SpindlySpider/spindlyVR/parts/PCB_body/body_ver0.FCStd

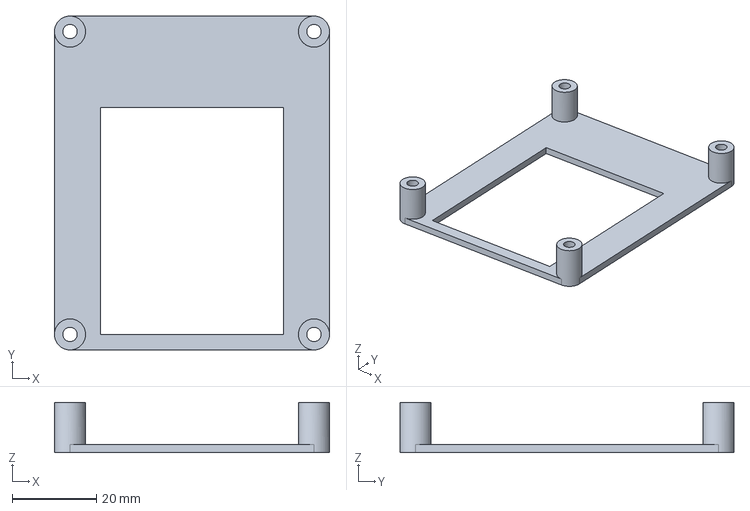
[picture p1: CAD file, 2026-05-15]
parts/PCB_body/body_ver0.FCStd
65.4 x 79.4 x 12.0 mm
