SpindlySpider/spindlyVR/parts/spools/adjustable_spool.FCStd

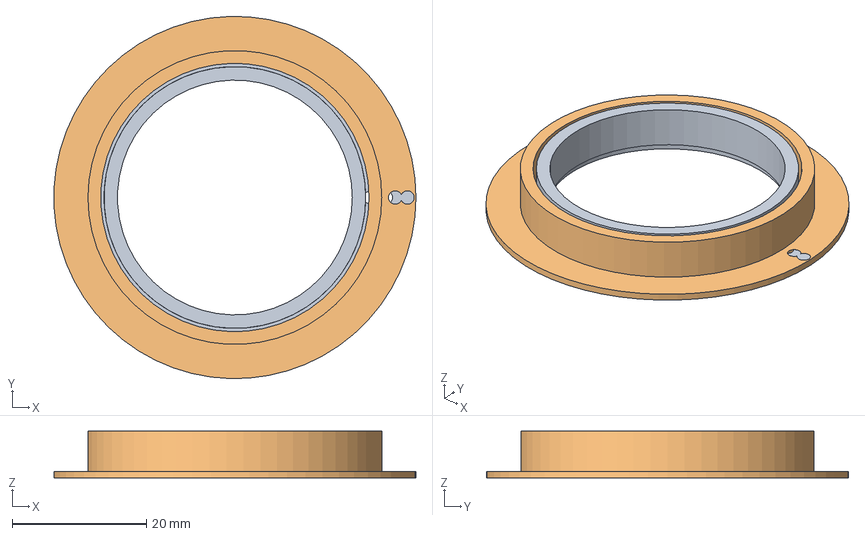
[picture p2: CAD file, 2026-05-15]
parts/spools/adjustable_spool.FCStd
54.0 x 54.0 x 7.00 mm
spool_top
spool_bottom
