SpindlySpider/spindlyVR/parts/tri-axis-magnet/ver-6-coil_001.step

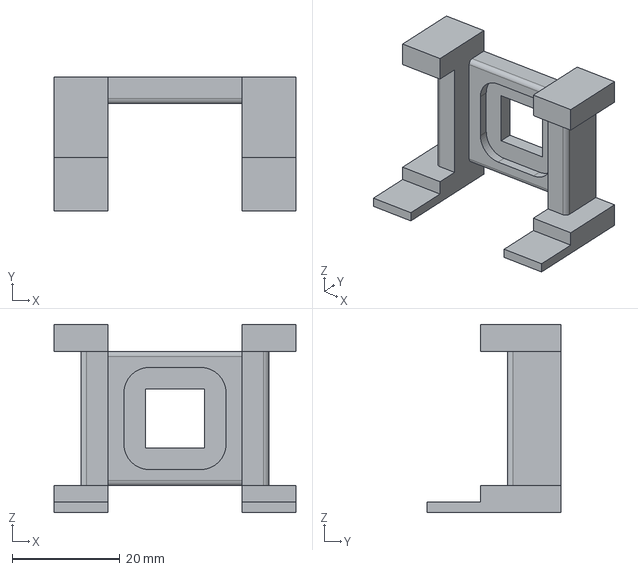
[picture p3: CAD file, 2026-05-15]
parts/tri-axis-magnet/ver-6-coil_001.step
45.0 x 25.0 x 35.0 mm
