SpindlySpider/spindlyVR/parts/tri-axis-magnet/ver-7.FCStd

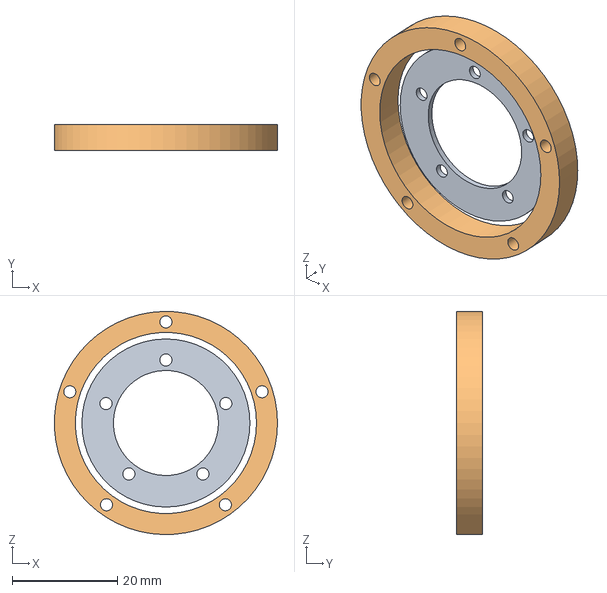
[picture p4: CAD file, 2026-05-15]
parts/tri-axis-magnet/ver-7.FCStd
42.5 x 5.00 x 42.5 mm
coil_1_flange
coil_2_hub
