SpindlySpider/spindlyVR/parts/tri-axis-magnet/ver-6-key001.step

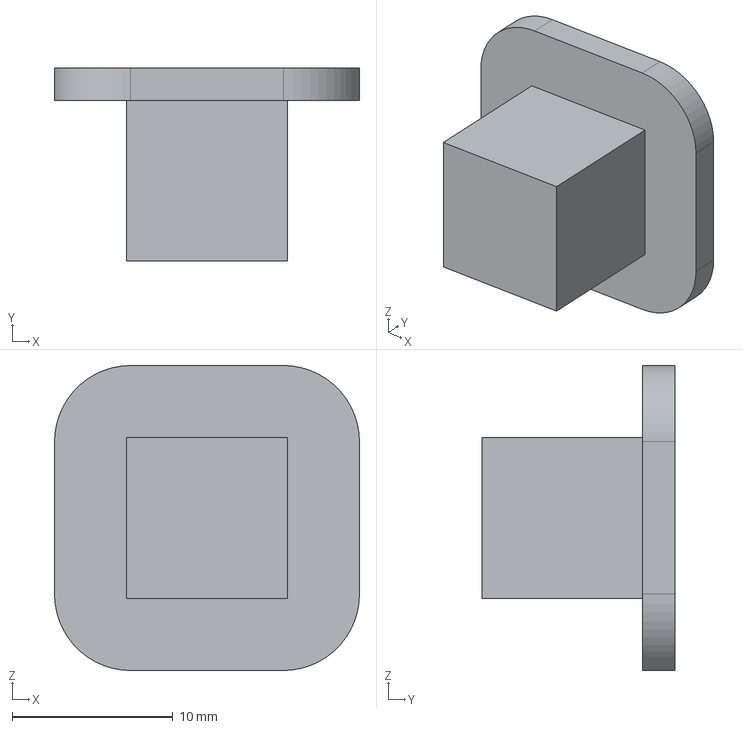
[picture p5: CAD file, 2026-05-15]
parts/tri-axis-magnet/ver-6-key001.step
19.0 x 12.0 x 19.0 mm
