SpindlySpider/spindlyVR/parts/tri-axis-magnet/ver-6-coil_003.step

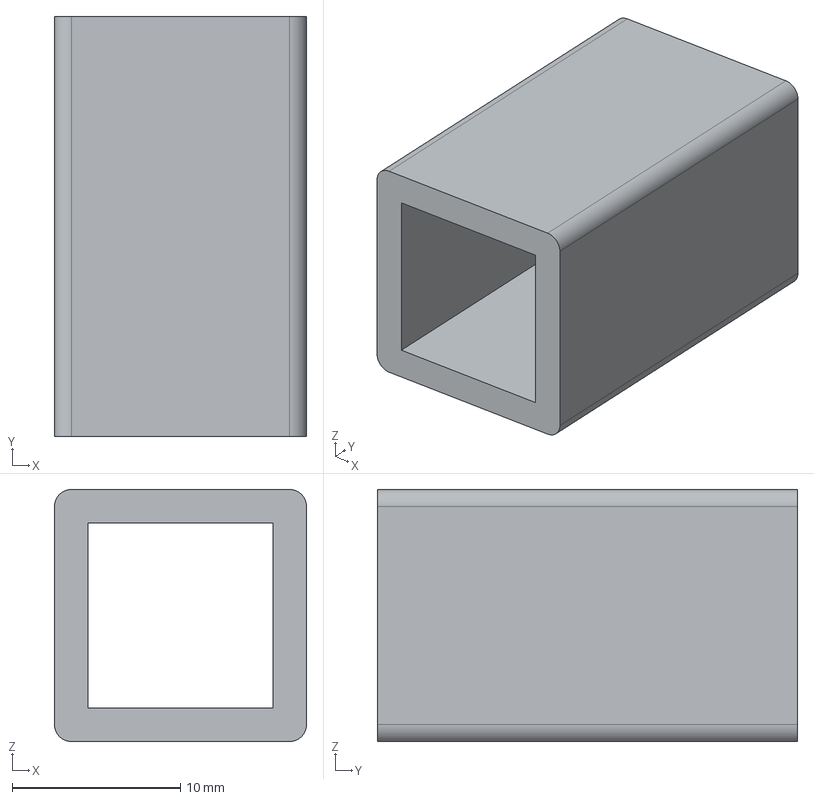
[picture p6: CAD file, 2026-05-15]
parts/tri-axis-magnet/ver-6-coil_003.step
15.0 x 25.0 x 15.0 mm
