SpindlySpider/spindlyVR/parts/tri-axis-magnet/ver-4-stepper-motor.FCStd

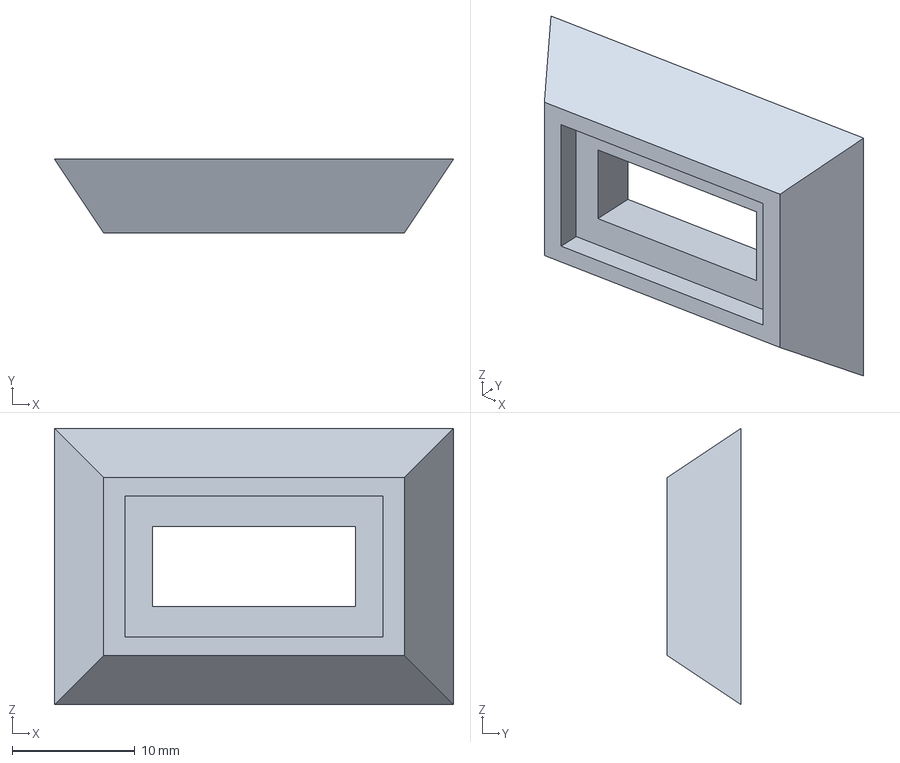
[picture p7: CAD file, 2025-12-07]
parts/tri-axis-magnet/ver-4-stepper-motor.FCStd
32.5 x 6.00 x 22.5 mm
