SpindlySpider/spindlyVR/parts/tri-axis-magnet/ver-3-stepper-mount.FCStd .FCStd

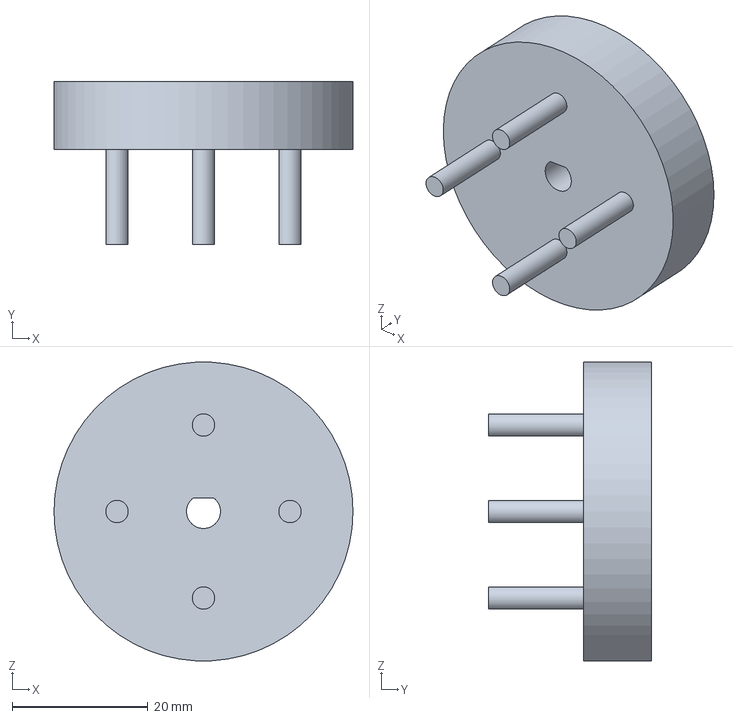
[picture p8: CAD file, 2025-12-04]
parts/tri-axis-magnet/ver-3-stepper-mount.FCStd .FCStd
44.0 x 24.0 x 43.9 mm
