SpindlySpider/spindlyVR/parts/tri-axis-magnet/ver-1-stepper-mount.FCStd

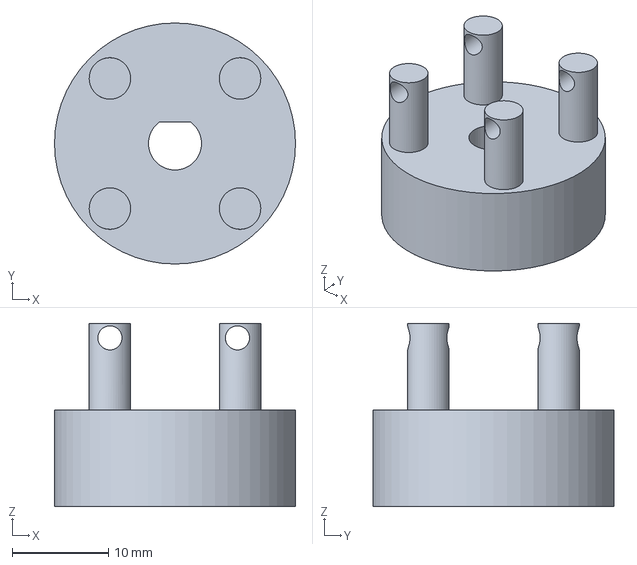
[picture p9: CAD file, 2025-12-03]
parts/tri-axis-magnet/ver-1-stepper-mount.FCStd
25.0 x 25.0 x 19.0 mm
