SpindlySpider/spindlyVR/parts/tri-axis-magnet/ver-6.FCStd

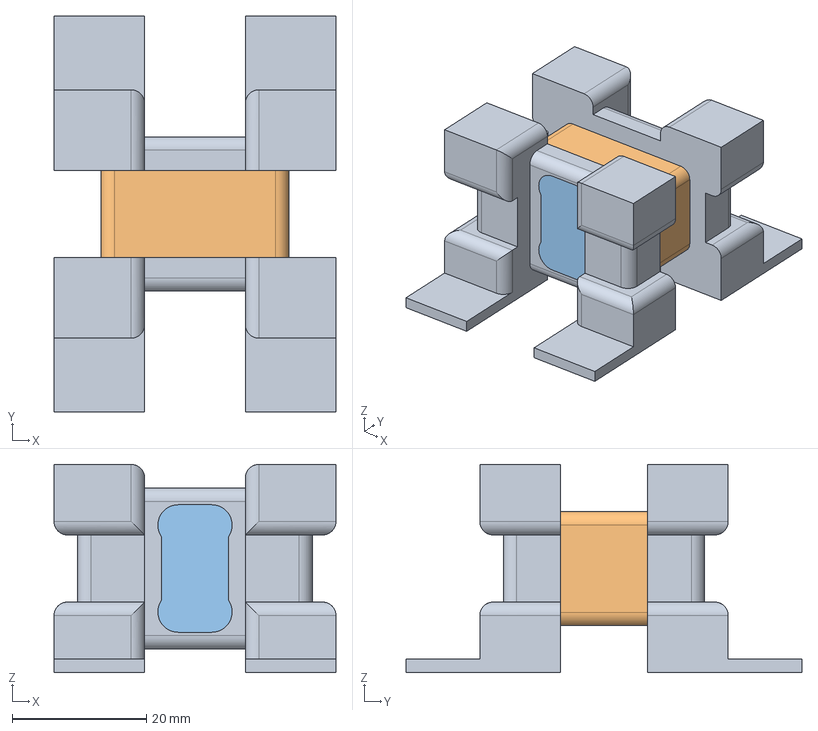
[picture p10: CAD file, 2026-05-15, an earlier design]
parts/tri-axis-magnet/ver-6.FCStd
42.0 x 59.0 x 31.0 mm
coil_1 x 2
coil_2
key x 2
