SpindlySpider/spindlyVR/parts/tri-axis-magnet/ver-5.FCStd

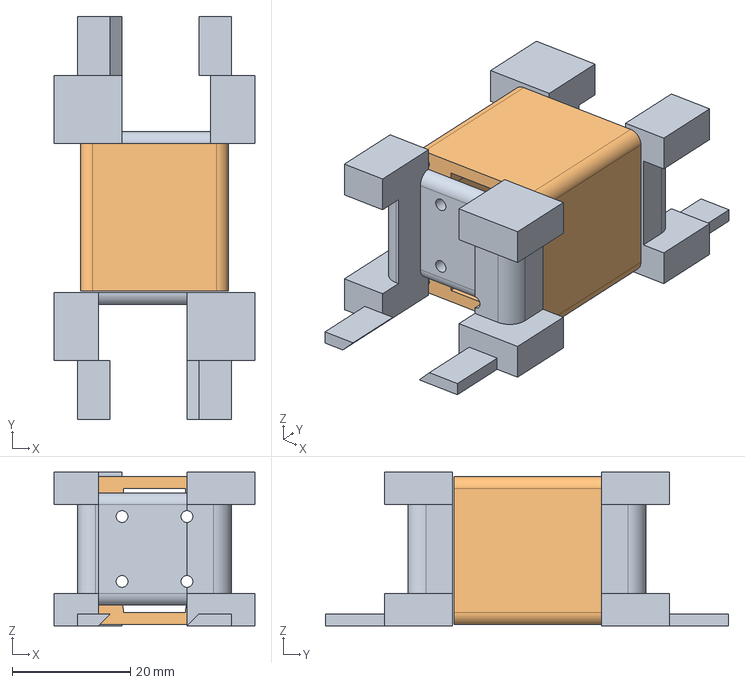
[picture p11: CAD file, 2026-05-15, an earlier design]
parts/tri-axis-magnet/ver-5.FCStd
34.0 x 68.2 x 26.0 mm
coil_1 x 2
coil_2
