SpindlySpider/spindlyVR/parts/tri-axis-magnet/ver-3.FCStd

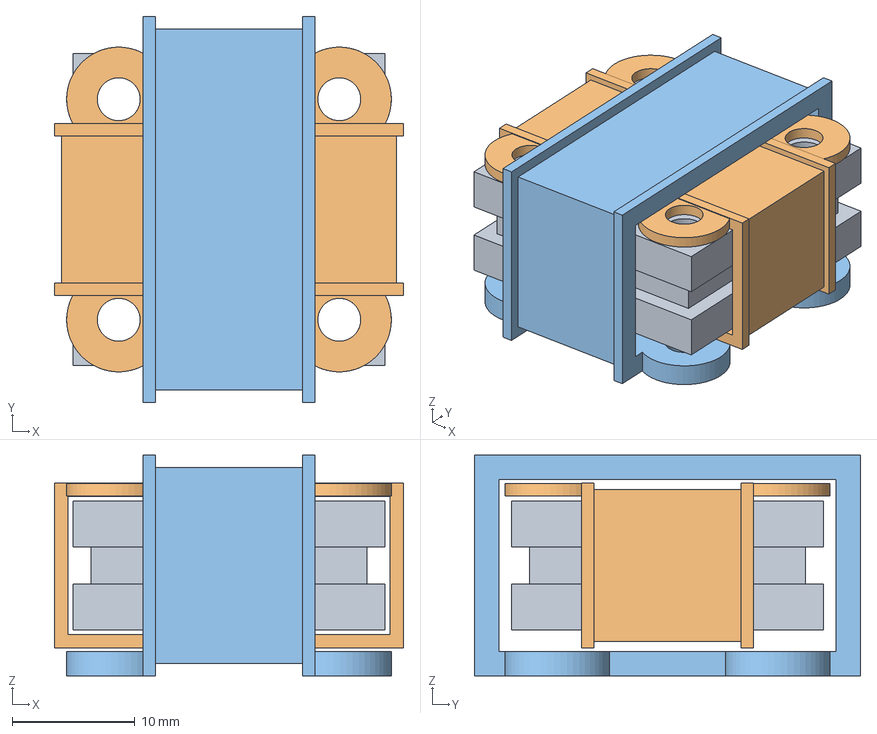
[picture p12: CAD file, 2025-12-07, an earlier design]
parts/tri-axis-magnet/ver-3.FCStd
28.5 x 31.5 x 18.0 mm
coil_1
coil_2
coil_3
