SpindlySpider/spindlyVR/parts/tri-axis-magnet/ver-2.FCStd

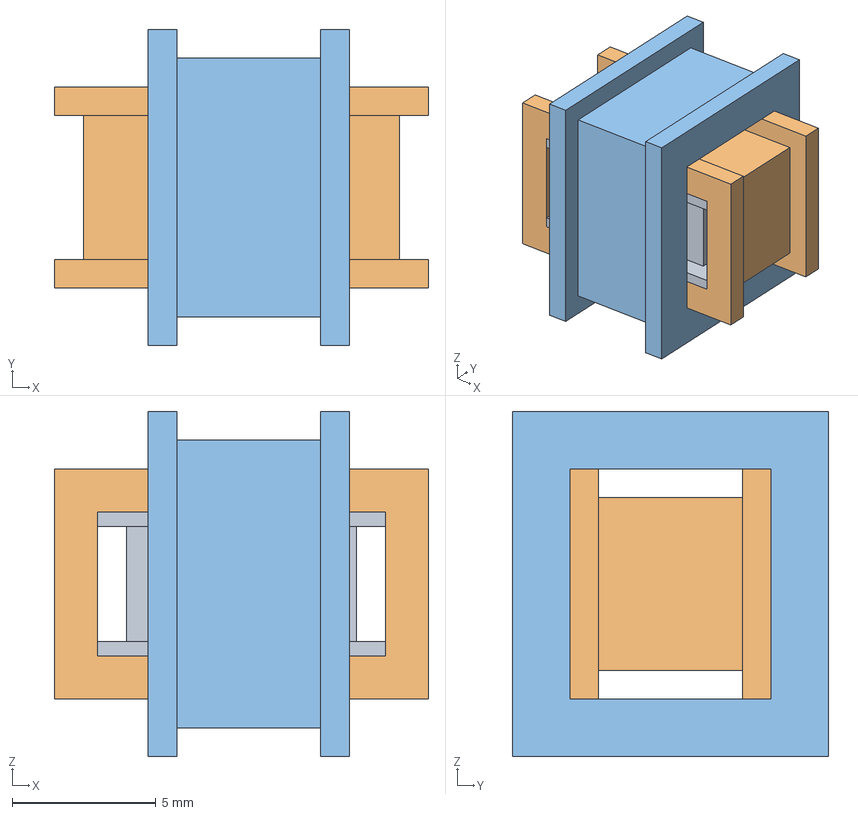
[picture p13: CAD file, 2025-12-04, an earlier design]
parts/tri-axis-magnet/ver-2.FCStd
13.0 x 11.0 x 12.0 mm
tri-axis-coil1
tri-axis-coil-2
tri-axis-coil-3
