SpindlySpider/spindlyVR/parts/tri-axis-magnet/ver-4.FCStd

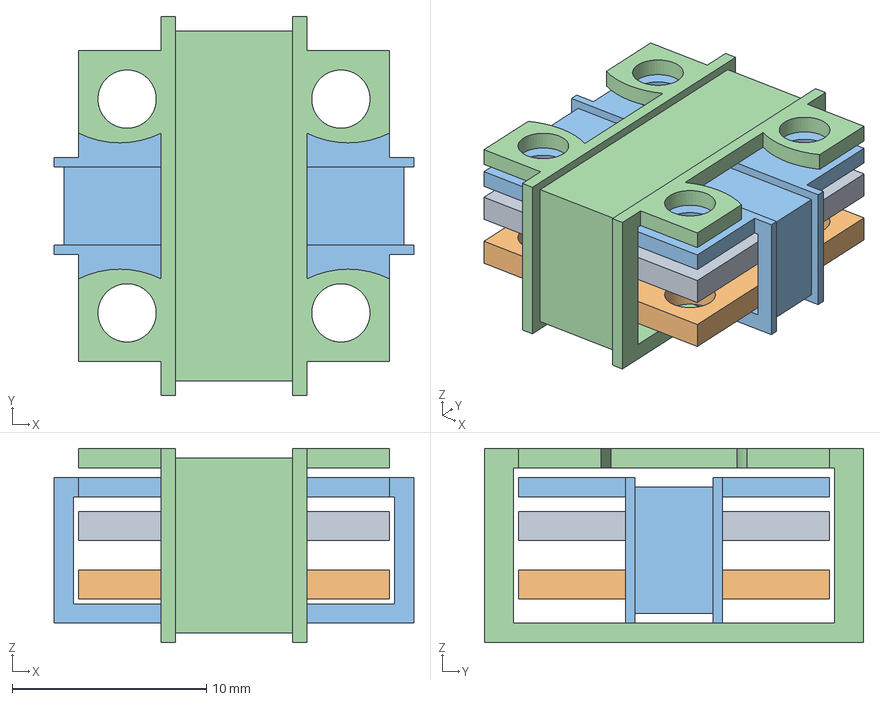
[picture p14: CAD file, 2025-12-04, an earlier design]
parts/tri-axis-magnet/ver-4.FCStd
18.5 x 19.5 x 10.0 mm
coil1_top
coil1_bottom
coil2
coil3
