SpindlySpider/spindlyVR/parts/tri-axis-magnet/ver-1.FCStd

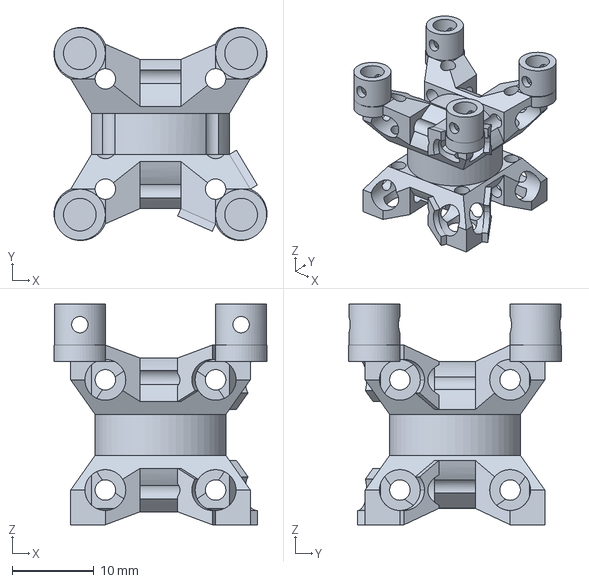
[picture p15: CAD file, 2025-12-03, an earlier design]
parts/tri-axis-magnet/ver-1.FCStd
26.1 x 26.1 x 27.0 mm
