SpindlySpider/spindlyVR/(list of files, cad)

Other CAD files:
parts/tri-axis-magnet/ver-1-assembly.FCStd
parts/spools/stepper_motor_mount.FCStd
