SpindlySpider/spindlyVR/pcb/rx/rx-proto0.kicad_pcb

## KiCad design pcb/rx/rx-proto0.kicad_pcb (2026-05-15)

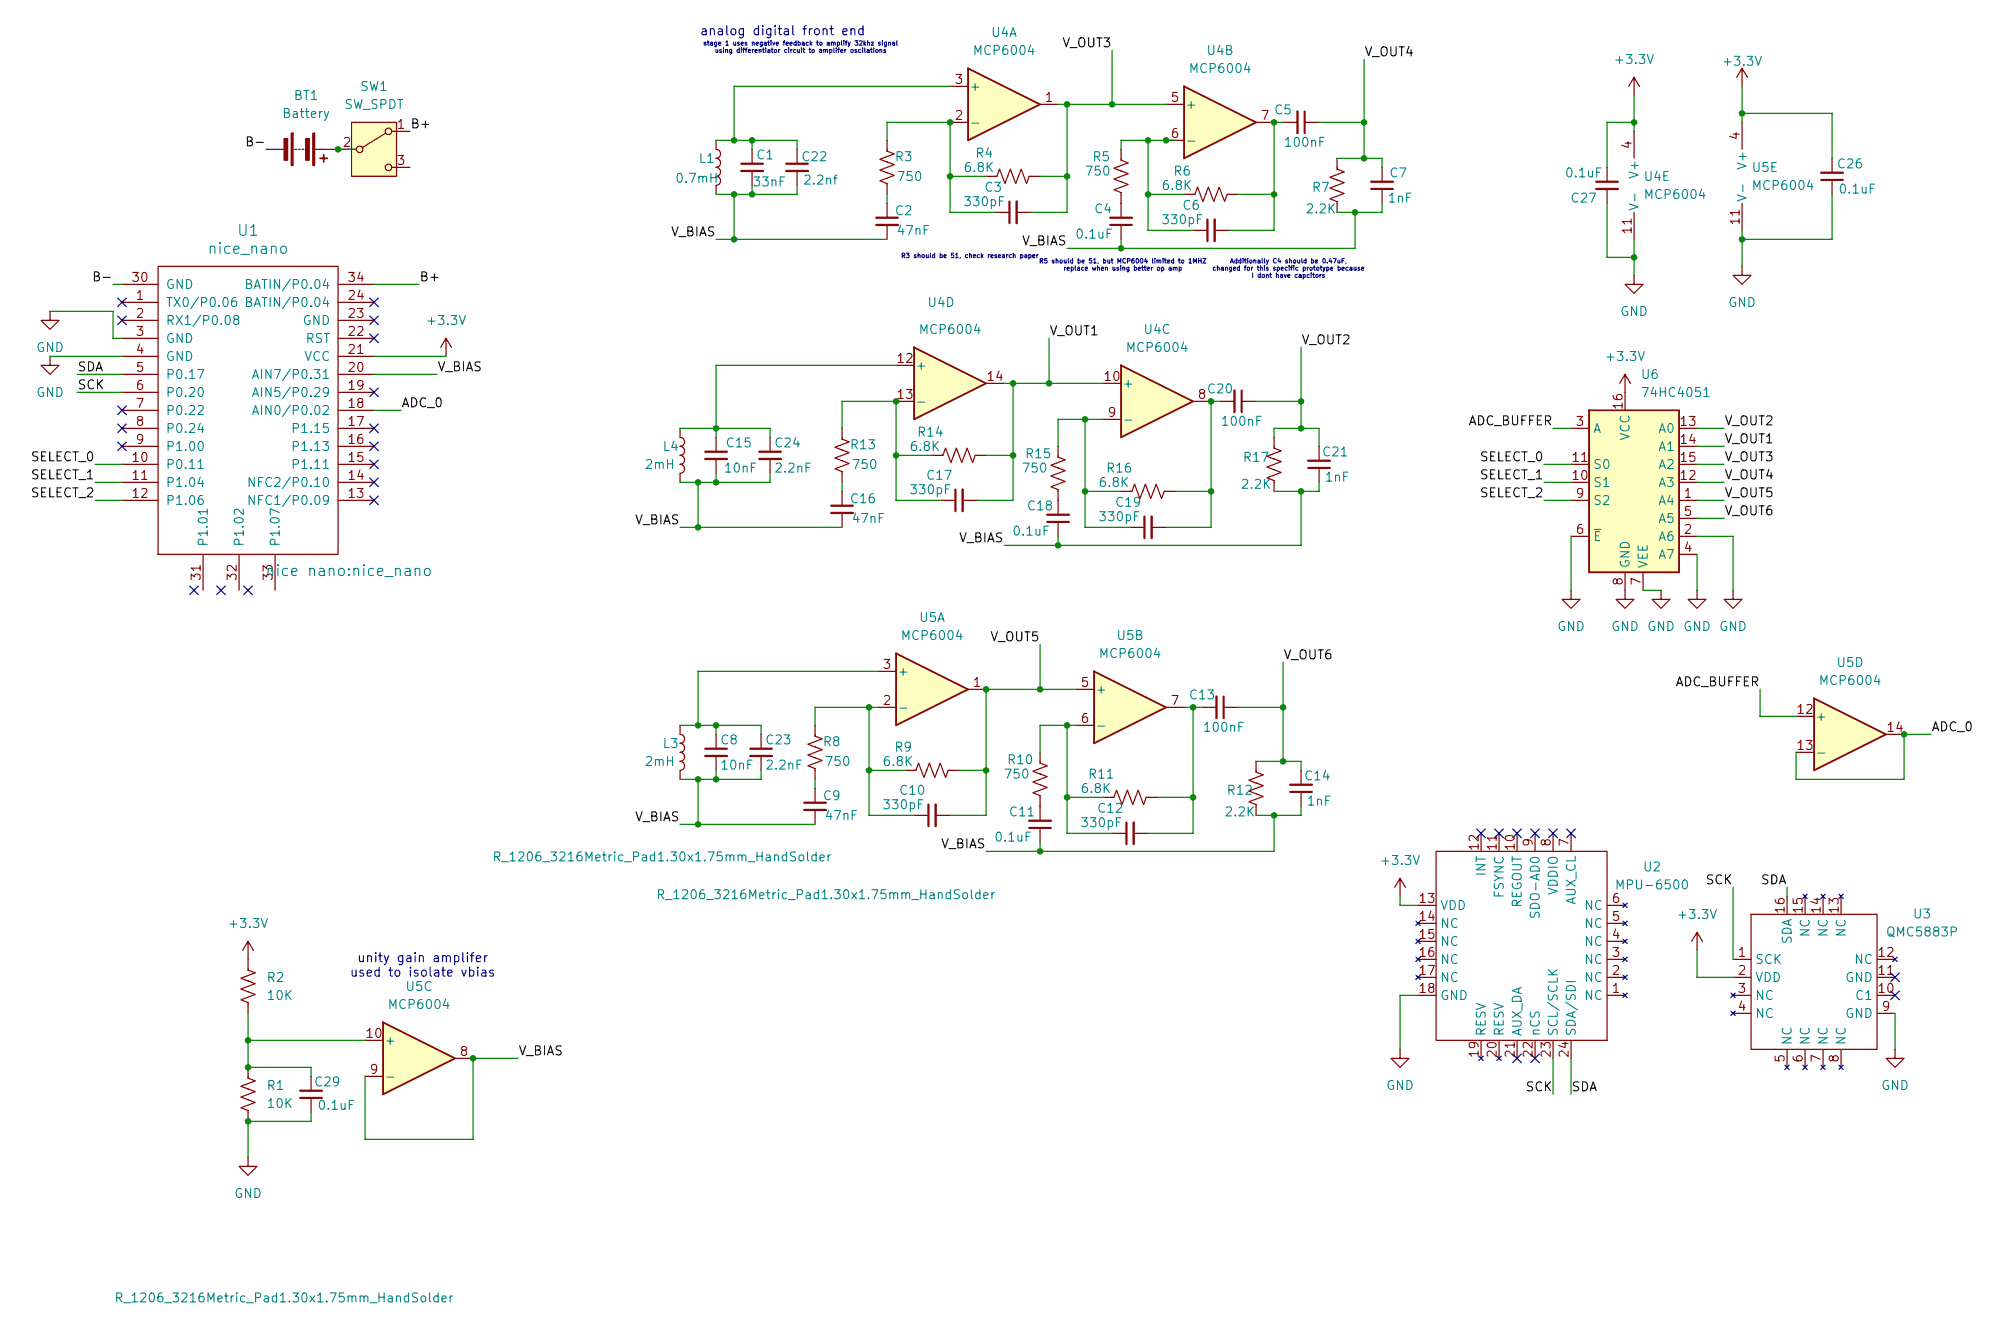
[picture p16: schematic rx-proto0.kicad_sch]

Parts:
BT1: Battery; JST_PH_B2B-PH-K_1x02_P2.00mm_Vertical
C1: 33nF; C_1206_3216Metric_Pad1.33x1.80mm_HandSolder
C2, C9, C16: 47nF; C_1206_3216Metric_Pad1.33x1.80mm_HandSolder
C3, C6, C10, C12, C17, C19: 330pF; C_1206_3216Metric_Pad1.33x1.80mm_HandSolder
C4, C11, C18, C26, C27, C29: 0.1uF; C_1206_3216Metric_Pad1.33x1.80mm_HandSolder
C5, C13, C20: 100nF; C_1206_3216Metric_Pad1.33x1.80mm_HandSolder
C7, C14, C21: 1nF; C_1206_3216Metric_Pad1.33x1.80mm_HandSolder
C8, C15: 10nF; C_1206_3216Metric_Pad1.33x1.80mm_HandSolder
C22: 2.2nf; C_1206_3216Metric_Pad1.33x1.80mm_HandSolder
C23, C24: 2.2nF; C_1206_3216Metric_Pad1.33x1.80mm_HandSolder
L1: 0.7mH; R_1206_3216Metric_Pad1.30x1.75mm_HandSolder
L3, L4: 2mH; R_1206_3216Metric_Pad1.30x1.75mm_HandSolder
R1, R2: 10K; R_1206_3216Metric_Pad1.30x1.75mm_HandSolder
R3, R5, R8, R10, R13, R15: 750; R_1206_3216Metric_Pad1.30x1.75mm_HandSolder
R4, R6, R9, R11, R14, R16: 6.8K; R_1206_3216Metric_Pad1.30x1.75mm_HandSolder
R7, R12, R17: 2.2K; R_1206_3216Metric_Pad1.30x1.75mm_HandSolder
SW1: SW_SPDT; EG1218
U1: nice_nano
U2: MPU-6500
U3: QMC5883P
U4, U5: MCP6004
U6: 74HC4051

Connections:
+3.3V: C26.2, C27.1, R2.1, U1.21 (VCC), U2.13 (VDD), U3.2 (VDD), U4.4 (V+), U5.4 (V+), U6.16 (VCC)
/ADC_0: U1.18 (AIN0/P0.02), U5.13 (-), U5.14
/ADC_BUFFER: U5.12 (+), U6.3 (A)
/B+: SW1.1 (A), U1.34 (BATIN/P0.04)
/B-: BT1.2 (-), U1.30 (GND)
/SCK: U1.6 (P0.20), U2.23 (SCL/SCLK), U3.1 (SCK)
/SDA: U1.5 (P0.17), U2.24 (SDA/SDI), U3.16 (SDA)
/SELECT_0: U1.10 (P0.11), U6.11 (S0)
/SELECT_1: U1.11 (P1.04), U6.10 (S1)
/SELECT_2: U1.12 (P1.06), U6.9 (S2)
/V_BIAS: C1.2, C2.2, C4.1, C7.1, C8.2, C9.2, C11.1, C14.1, C15.2, C16.2, C18.1, C21.1, C22.2, C23.2, C24.2, L1.2, L3.2, L4.2, R7.2, R12.2, R17.2, U1.20 (AIN7/P0.31), U5.8, U5.9 (-)
/V_OUT1: C17.2, R14.1, U4.10 (+), U4.14, U6.14 (A1)
/V_OUT2: C20.1, C21.2, R17.1, U6.13 (A0)
/V_OUT3: C3.2, R4.1, U4.1, U4.5 (+), U6.15 (A2)
/V_OUT4: C5.1, C7.2, R7.1, U6.12 (A3)
/V_OUT5: C10.2, R9.1, U5.1, U5.5 (+), U6.1 (A4)
/V_OUT6: C13.1, C14.2, R12.1, U6.5 (A5)
GND: C26.1, C27.2, C29.1, R1.2, U1.3 (GND), U1.4 (GND), U2.18 (GND), U3.9 (GND), U4.11 (V-), U5.11 (V-), U6.2 (A6), U6.4 (A7), U6.6 (~E), U6.7 (VEE), U6.8 (GND)
unnamed: BT1.1 (+), SW1.2 (B)
unnamed: C2.1, R3.2
unnamed: C4.2, R5.2
unnamed: C5.2, C6.2, R6.1, U4.7
unnamed: C9.1, R8.2
unnamed: C11.2, R10.2
unnamed: C12.2, C13.2, R11.1, U5.7
unnamed: C16.1, R13.2
unnamed: C18.2, R15.2
unnamed: C19.2, C20.2, R16.1, U4.8
unnamed: C1.1, C22.1, L1.1, U4.3 (+)
unnamed: C3.1, R3.1, R4.2, U4.2 (-)
unnamed: C6.1, R5.1, R6.2, U4.6 (-)
unnamed: C19.1, R15.1, R16.2, U4.9 (-)
unnamed: C15.1, C24.1, L4.1, U4.12 (+)
unnamed: C17.1, R13.1, R14.2, U4.13 (-)
unnamed: C8.1, C23.1, L3.1, U5.3 (+)
unnamed: C10.1, R8.1, R9.2, U5.2 (-)
unnamed: C12.1, R10.1, R11.2, U5.6 (-)
unnamed: C29.2, R1.1, R2.2, U5.10 (+)

Notes on the sheet:
unity gain amplifer used to isolate vbias
R5 should be 51, but MCP6004 limited to 1MHZ replace when using better op amp
analog digital front end
stage 1 uses negative feedback to amplify 32khz signal using differentiator circuit to amplifer oscilations
Additionally C4 should be 0.47uF, changed for this specific prototype because I dont have capcitors
R3 should be 51, check research paper

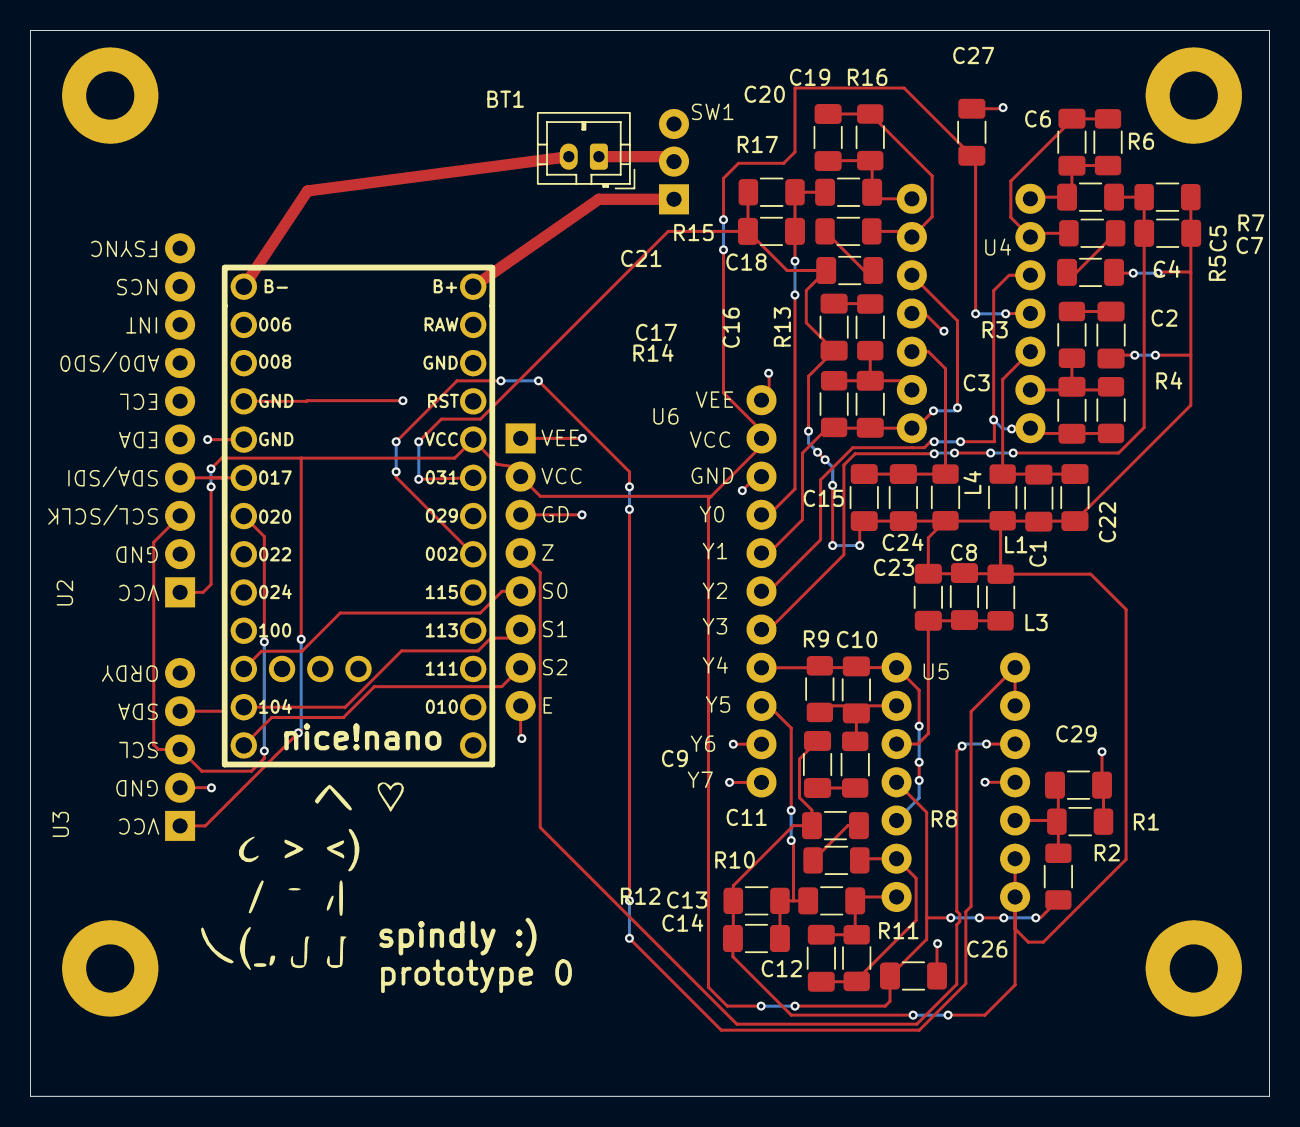
[picture p17: board rx-proto0.kicad_pcb from above]

Board: 2 copper layers, 82.3 x 70.8 mm, 55 parts (0 on the bottom side), 38 nets.
