SpindlySpider/spindlyVR/pcb/rx/rx.kicad_pcb

## KiCad design pcb/rx/rx.kicad_pcb (2026-05-15)

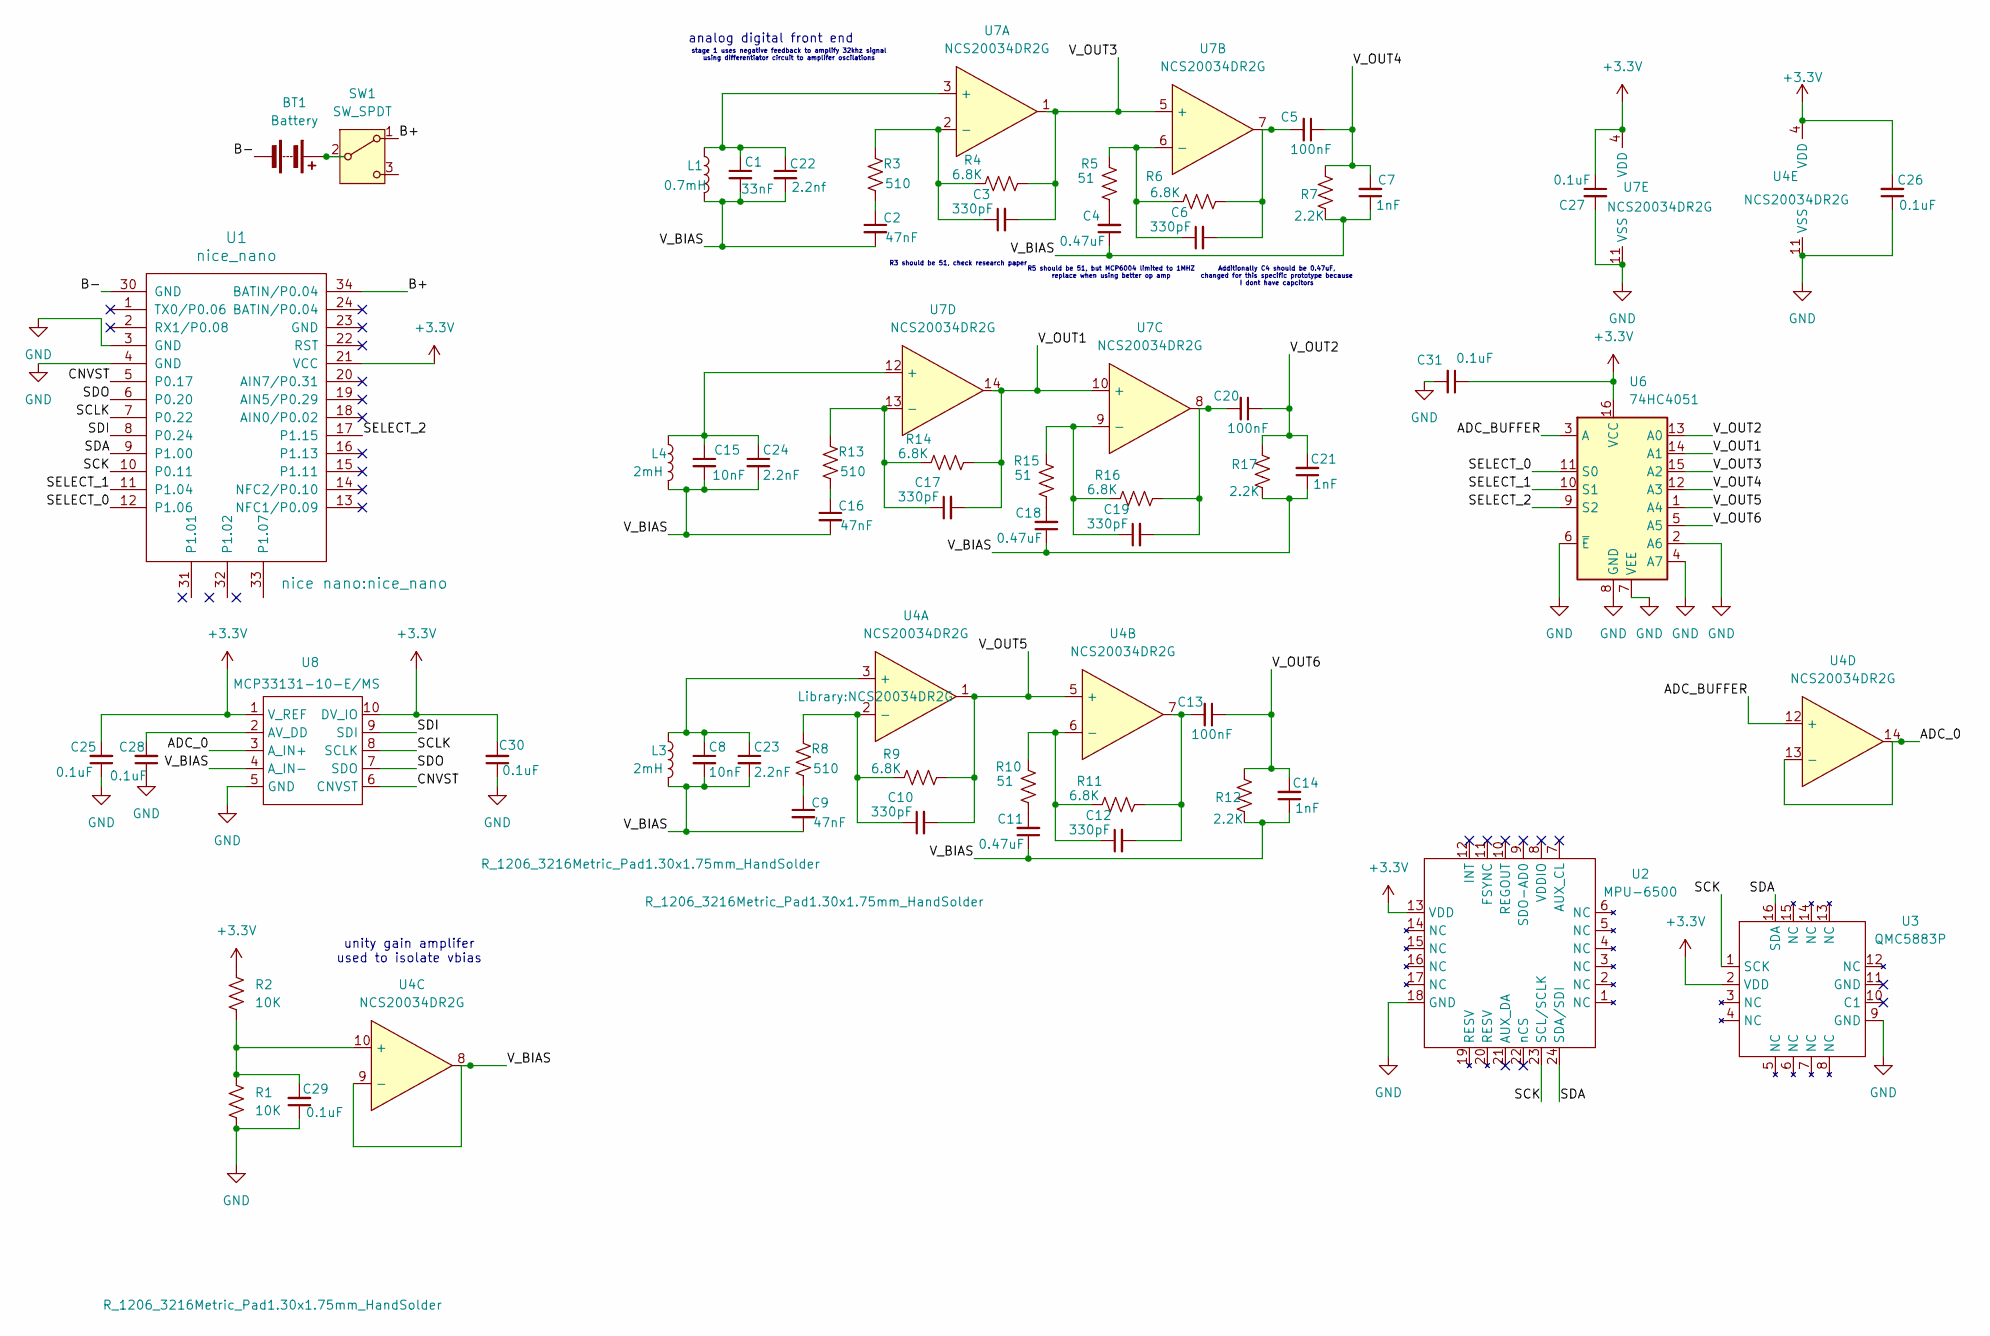
[picture p18: schematic rx.kicad_sch]

Parts:
BT1: Battery; JST_PH_B2B-PH-K_1x02_P2.00mm_Vertical
C1: 33nF; C_1206_3216Metric_Pad1.33x1.80mm_HandSolder
C2, C9, C16: 47nF; C_1206_3216Metric_Pad1.33x1.80mm_HandSolder
C3, C6, C10, C12, C17, C19: 330pF; C_1206_3216Metric_Pad1.33x1.80mm_HandSolder
C4, C11, C18: 0.47uF; C_1206_3216Metric_Pad1.33x1.80mm_HandSolder
C5, C13, C20: 100nF; C_1206_3216Metric_Pad1.33x1.80mm_HandSolder
C7, C14, C21: 1nF; C_1206_3216Metric_Pad1.33x1.80mm_HandSolder
C8, C15: 10nF; C_1206_3216Metric_Pad1.33x1.80mm_HandSolder
C22: 2.2nf; C_1206_3216Metric_Pad1.33x1.80mm_HandSolder
C23, C24: 2.2nF; C_1206_3216Metric_Pad1.33x1.80mm_HandSolder
C25, C26, C27, C28, C29, C30, C31: 0.1uF; C_1206_3216Metric_Pad1.33x1.80mm_HandSolder
L1: 0.7mH; R_1206_3216Metric_Pad1.30x1.75mm_HandSolder
L3, L4: 2mH; R_1206_3216Metric_Pad1.30x1.75mm_HandSolder
R1, R2: 10K; R_1206_3216Metric_Pad1.30x1.75mm_HandSolder
R3, R8, R13: 510; R_1206_3216Metric_Pad1.30x1.75mm_HandSolder
R4, R6, R9, R11, R14, R16: 6.8K; R_1206_3216Metric_Pad1.30x1.75mm_HandSolder
R5, R10, R15: 51; R_1206_3216Metric_Pad1.30x1.75mm_HandSolder
R7, R12, R17: 2.2K; R_1206_3216Metric_Pad1.30x1.75mm_HandSolder
SW1: SW_SPDT; EG1218
U1: nice_nano
U2: MPU-6500
U3: QMC5883P
U4, U7: NCS20034DR2G
U6: 74HC4051; 74HC4051-chip
U8: MCP33131-10-E/MS; MCP33131

Connections:
+3.3V: C25.2, C26.2, C27.1, C30.2, C31.1, R2.1, U1.21 (VCC), U2.13 (VDD), U3.2 (VDD), U4.4 (VDD), U6.16 (VCC), U7.4 (VDD), U8.1 (V_REF), U8.10 (DV_IO)
/ADC_0: U4.13 (-), U4.14, U8.3 (A_IN+)
/ADC_BUFFER: U4.12 (+), U6.3 (A)
/B+: SW1.1 (A), U1.34 (BATIN/P0.04)
/B-: BT1.2 (-), U1.30 (GND)
/CNVST: U1.5 (P0.17), U8.6 (CNVST)
/SCK: U1.10 (P0.11), U2.23 (SCL/SCLK), U3.1 (SCK)
/SCLK: U1.7 (P0.22), U8.8 (SCLK)
/SDA: U1.9 (P1.00), U2.24 (SDA/SDI), U3.16 (SDA)
/SDI: U1.8 (P0.24), U8.9 (SDI)
/SDO: U1.6 (P0.20), U8.7 (SDO)
/SELECT_0: U1.12 (P1.06), U6.11 (S0)
/SELECT_1: U1.11 (P1.04), U6.10 (S1)
/SELECT_2: U1.17 (P1.15), U6.9 (S2)
/V_BIAS: C1.2, C2.2, C4.1, C7.1, C8.2, C9.2, C11.1, C14.1, C15.2, C16.2, C18.1, C21.1, C22.2, C23.2, C24.2, L1.2, L3.2, L4.2, R7.2, R12.2, R17.2, U4.8, U4.9 (-), U8.4 (A_IN-)
/V_OUT1: C17.2, R14.1, U6.14 (A1), U7.10 (+), U7.14
/V_OUT2: C20.1, C21.2, R17.1, U6.13 (A0)
/V_OUT3: C3.2, R4.1, U6.15 (A2), U7.1, U7.5 (+)
/V_OUT4: C5.1, C7.2, R7.1, U6.12 (A3)
/V_OUT5: C10.2, R9.1, U4.1, U4.5 (+), U6.1 (A4)
/V_OUT6: C13.1, C14.2, R12.1, U6.5 (A5)
GND: C25.1, C26.1, C27.2, C28.1, C29.1, C30.1, C31.2, R1.2, U1.3 (GND), U1.4 (GND), U2.18 (GND), U3.9 (GND), U4.11 (VSS), U6.2 (A6), U6.4 (A7), U6.6 (~E), U6.7 (VEE), U6.8 (GND), U7.11 (VSS), U8.5 (GND)
unnamed: BT1.1 (+), SW1.2 (B)
unnamed: C2.1, R3.2
unnamed: C4.2, R5.2
unnamed: C5.2, C6.2, R6.1, U7.7
unnamed: C9.1, R8.2
unnamed: C11.2, R10.2
unnamed: C12.2, C13.2, R11.1, U4.7
unnamed: C16.1, R13.2
unnamed: C18.2, R15.2
unnamed: C19.2, C20.2, R16.1, U7.8
unnamed: C8.1, C23.1, L3.1, U4.3 (+)
unnamed: C10.1, R8.1, R9.2, U4.2 (-)
unnamed: C12.1, R10.1, R11.2, U4.6 (-)
unnamed: C29.2, R1.1, R2.2, U4.10 (+)
unnamed: C1.1, C22.1, L1.1, U7.3 (+)
unnamed: C3.1, R3.1, R4.2, U7.2 (-)
unnamed: C6.1, R5.1, R6.2, U7.6 (-)
unnamed: C19.1, R15.1, R16.2, U7.9 (-)
unnamed: C15.1, C24.1, L4.1, U7.12 (+)
unnamed: C17.1, R13.1, R14.2, U7.13 (-)
unnamed: C28.2, U8.2 (AV_DD)

Notes on the sheet:
unity gain amplifer used to isolate vbias
R5 should be 51, but MCP6004 limited to 1MHZ replace when using better op amp
analog digital front end
stage 1 uses negative feedback to amplify 32khz signal using differentiator circuit to amplifer oscilations
Additionally C4 should be 0.47uF, changed for this specific prototype because I dont have capcitors
R3 should be 51, check research paper

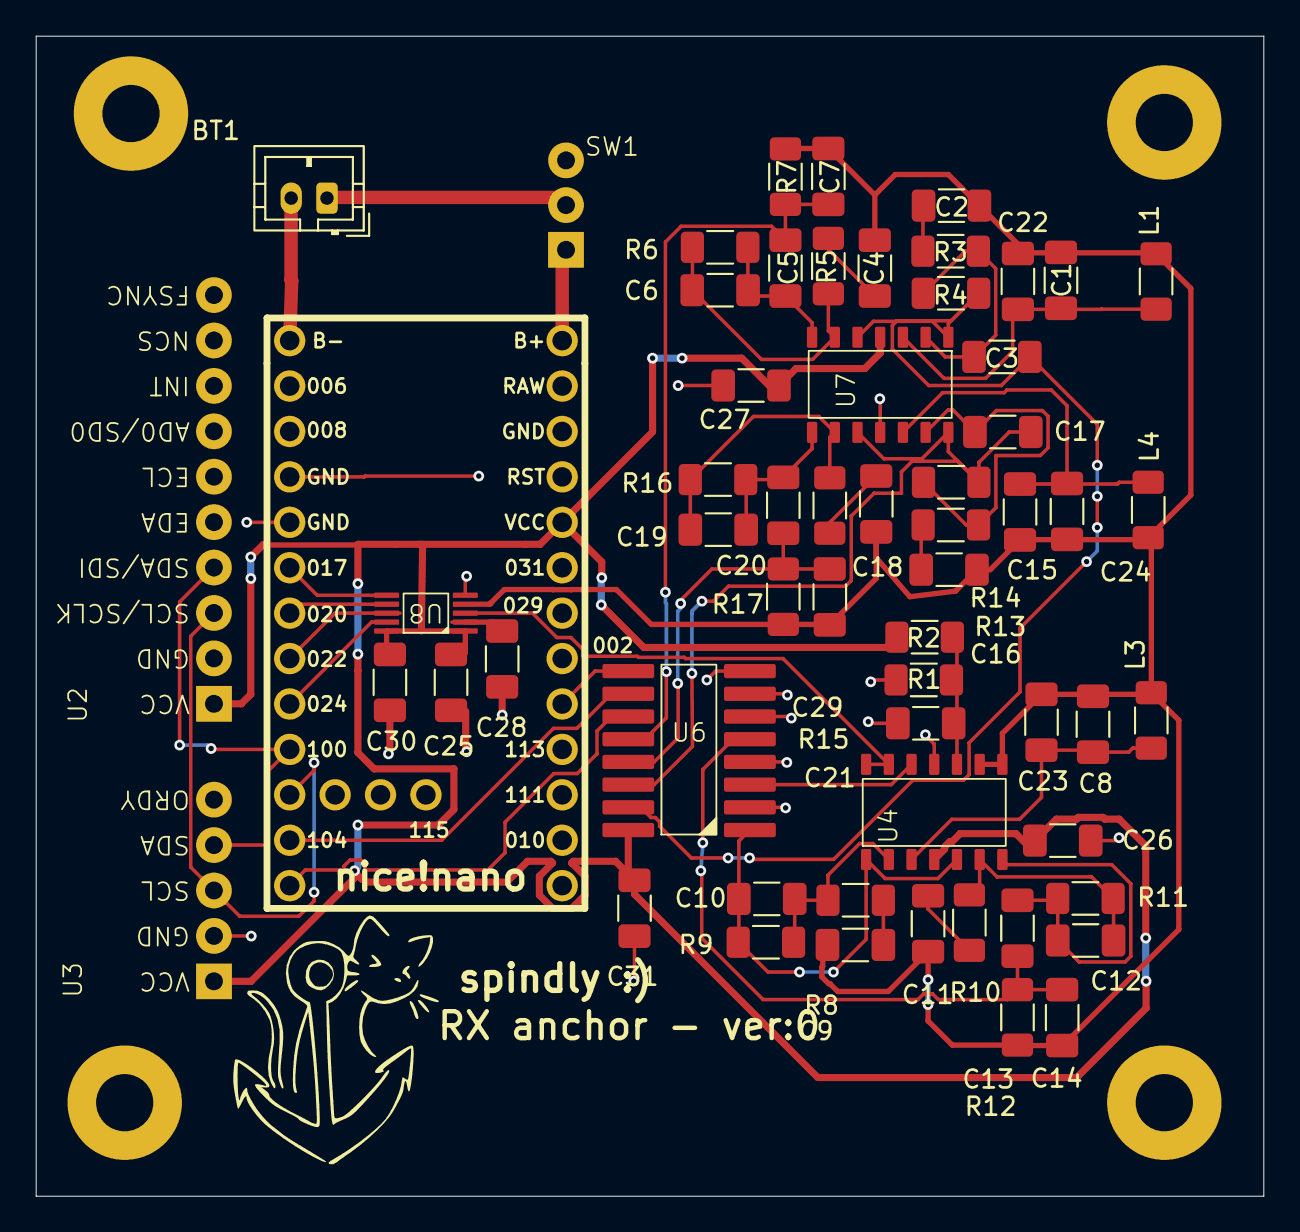
[picture p19: board rx.kicad_pcb from above]

Board: 2 copper layers, 68.7 x 64.9 mm, 60 parts (0 on the bottom side), 43 nets.
