SpindlySpider/spindlyVR/transmitter/src/adc.c

#include "data_handle.h"
#include "hal/nrf_timer.h"
#include "nrfx_templates_config.h"
#include <helpers/nrfx_gppi.h>
#include <math.h>
#include <nrfx_saadc.h>
#include <nrfx_timer.h>
#include <stdint.h>
#include <zephyr/devicetree.h>
#include <zephyr/irq.h>
#include <zephyr/kernel.h>
#include <zephyr/sys/printk.h>

#include "nrfx_templates_config.h"
#include "transmit_data.h"
#include <math.h>

#include "adc.h"

#define PI 3.14159265f
#define SAADC_INPUT_PIN NRF_SAADC_INPUT_AIN0 // pin 0.02

K_SEM_DEFINE(adc_semaphore, 0, 1);
K_SEM_DEFINE(adc_radio_sync_semaphore, 0, 1);

// setup timer
static nrfx_timer_t timer_inst = NRFX_TIMER_INSTANCE(NRF_TIMER_INST_GET(3));

static nrfx_timer_t tx_timer = NRFX_TIMER_INSTANCE(NRF_TIMER_INST_GET(4));

int16_t sample_buf[CONFIG_TX_SAMPLE_NUMBER];
int32_t val_mv;
int32_t err;

// NOTE: store 100(default) signal entries for phase and amp calculation
static float amp_bias;
struct cached_sin_cos_t cached_s_c = {.sine = {}, .cosine = {}};

static void saadc_handler(nrfx_saadc_evt_t const *p_event) {
  switch (p_event->type) {
  case NRFX_SAADC_EVT_DONE:
    k_sem_give(&adc_semaphore);
    break;
  }
}

int config_saadc() {
  int err;
  // incredibly useful:
  // https://github.com/zephyrproject-rtos/hal_nordic/tree/master/nrfx/samples/src/nrfx_saadc/advanced_non_blocking_internal_timer
  IRQ_CONNECT(NRFX_IRQ_NUMBER_GET(NRF_SAADC), IRQ_PRIO_LOWEST,
              nrfx_saadc_irq_handler, 0, 0);

  // irq_enable(NRFX_IRQ_NUMBER_GET(NRF_SAADC));
  err = nrfx_saadc_init(NRFX_SAADC_DEFAULT_CONFIG_IRQ_PRIORITY);
  if (err != 0) {
    printk("Error setting up SAADC: %d\n", err);
    return err;
  }
  // setup ADC pin for use
  nrfx_saadc_channel_t default_channel =
      NRFX_SAADC_DEFAULT_CHANNEL_SE(SAADC_INPUT_PIN, 0);

  // setup channel for 3 microsecond
  default_channel.channel_config.acq_time = NRF_SAADC_ACQTIME_3US;
  // setup channel for 3 microsecond, NO resistors, and 3.3V scaling
  default_channel.channel_config.acq_time = NRF_SAADC_ACQTIME_3US;
  default_channel.channel_config.gain = NRF_SAADC_GAIN1_6; // Multiply by 1/4
  //

  err = nrfx_saadc_channel_config(&default_channel);

  if (err != 0) {
    printk("Error setting up SAADC channel: %d\n", err);
    return err;
  }

  nrfx_saadc_adv_config_t adv_config = NRFX_SAADC_DEFAULT_ADV_CONFIG;

  uint32_t channel_mask = nrfx_saadc_channels_configured_get();

  err = nrfx_saadc_advanced_mode_set(channel_mask, NRF_SAADC_RESOLUTION_12BIT,
                                     &adv_config, saadc_handler);

  if (err != 0) {
    return err;
  }

  // init buffer
  // nrfx_saadc_buffer_set(sample_buf, CONFIG_TX_SAMPLE_NUMBER);

  nrf_saadc_channel_input_set(NRF_SAADC, 0, SAADC_INPUT_PIN,
                              NRF_SAADC_INPUT_DISABLED);

  return 0;
}

int config_timer() {
  // incredibly useful:
  // https://github.com/zephyrproject-rtos/hal_nordic/tree/master/nrfx/samples/src/nrfx_timer
  IRQ_CONNECT(NRFX_IRQ_NUMBER_GET(NRF_TIMER3), IRQ_PRIO_LOWEST,
              nrfx_timer_irq_handler, &timer_inst, 0);

  // get frequency from register - returns 0 for 16mhz
  uint32_t frequency = NRF_TIMER_BASE_FREQUENCY_GET(timer_inst.p_reg);
  nrfx_timer_config_t config = NRFX_TIMER_DEFAULT_CONFIG(frequency);

  int err = nrfx_timer_init(&timer_inst, &config, NULL);
  if (err != 0) {
    printk("error setting up timer: d%", err);
    return err;
  }

  // nrfx_timer_clear(&timer_inst);

  // need 100 ticks to get 160khz (default ADC value) from 16mhz e.g. 16,000,000
  // get khz
  uint32_t desired_ticks = frequency / (CONFIG_TX_ADC_FREQUENCY * 1000);

  nrfx_timer_extended_compare(&timer_inst, NRF_TIMER_CC_CHANNEL0, desired_ticks,
                              NRF_TIMER_SHORT_COMPARE0_CLEAR_MASK, false);

  nrfx_timer_enable(&timer_inst);
  printk("Started timer ticking every %d ticks\n", desired_ticks);
  k_msleep(1000);

  return 0;
}

int config_ppi() {
  // set up generic PPI
  nrfx_gppi_handle_t gppi_handle;
  nrfx_gppi_handle_t gppi_start;
  nrfx_gppi_handle_t gppi_adc_timestamp;

  // connect timer event compare0 to saadc task sample (take a sample each time
  // timer ticks)
  int err = nrfx_gppi_conn_alloc(
      nrf_timer_event_address_get(NRF_TIMER3, NRF_TIMER_EVENT_COMPARE0),
      nrf_saadc_task_address_get(NRF_SAADC, NRF_SAADC_TASK_SAMPLE),
      &gppi_handle);

  if (err != 0) {
    return err;
  }

  // when buffer is full start new SAADC task
  nrfx_gppi_conn_alloc(
      nrf_saadc_event_address_get(NRF_SAADC, NRF_SAADC_EVENT_STARTED),
      nrf_timer_task_address_get(NRF_TIMER3, NRF_TIMER_TASK_START),
      &gppi_start);
  if (err != 0) {
    return err;
  }

  // timestamp when ADC has finished taking readings
  err = nrfx_gppi_conn_alloc(
      nrf_saadc_event_address_get(NRF_SAADC, NRF_SAADC_EVENT_STARTED),
      nrf_timer_task_address_get(NRF_TIMER4, NRF_TIMER_TASK_CAPTURE3),
      &gppi_adc_timestamp);
  if (err != 0) {
    return err;
  }

  // enable this connection
  nrfx_gppi_conn_enable(gppi_start);
  nrfx_gppi_conn_enable(gppi_handle);
  nrfx_gppi_conn_enable(gppi_adc_timestamp);
  return 0;
}

int tx_matched_filter(struct cached_sin_cos_t *cached_s_c) {
  // NOTE: signal buf should be an array of samples from ADC
  float sin_accumulation = 0.0f;
  float cos_accumulation = 0.0f;
  float amp = 0.0f;
  float phase = 0.0f;
  int32_t dc_sum = 0;

  for (int i = 0; i < CONFIG_TX_SAMPLE_NUMBER; i++) {
    dc_sum += sample_buf[i];
  }
  // centre offset
  float true_dc_offset = (float)dc_sum / (float)CONFIG_TX_SAMPLE_NUMBER;

  for (int i = 0; i < CONFIG_TX_SAMPLE_NUMBER; i++) {
    float ac_wave_signal = (float)sample_buf[i] - true_dc_offset;

    sin_accumulation += (cached_s_c->sine[i] * ac_wave_signal);
    cos_accumulation += (cached_s_c->cosine[i] * ac_wave_signal);
  }

  amp = ((sqrtf(powf(sin_accumulation, 2) + powf(cos_accumulation, 2)) /
          CONFIG_TX_SAMPLE_NUMBER));
  // multiply by 2 because the amplitude was divided by 2
  amp = amp * 2.0f;

  // normalise to volts, 4096 because its the ADC bit depth .e.g. 2**12
  // 3.6 because its the gain range for ADC 1/6
  // gets peak voltage in volts
  amp = (amp / 4096.0f) * 3.6f;

  // dependent on coil direction
  phase = atan2f(-sin_accumulation, cos_accumulation);
  uint32_t adc_timestamp =
      nrfx_timer_capture_get(&tx_timer, NRF_TIMER_CC_CHANNEL3);

  // update container
  update_signal_data(amp, phase, adc_timestamp);
  // use semaphore
  k_sem_give(&adc_radio_sync_semaphore);

  return 0;
}

// TODO: make a thread function which keeps track of signal buffer and updates
// shared data var would need to call read ADC a couple of times and then save
// result in buffer

void start_adc_thread(void *, void *, void *) {
  // this function acts as entry point for starting a thread
  // if the next buffer is ready to be filled
  int err;

  printk("setting up adc\n");
  err = setup_sin_cos_cache(&cached_s_c);
  if (err != 0) {
    printk("Failed to setup sine and cosine cache: %d\n", err);
    // NOTE: should continue and read to read again
  }

  // NOTE: 12 is comming from ADC bit resolution, this should probably be
  // place in the KCONFIG
  amp_bias = 3.3 / powf(2, 12);

  printk("setting up saadc\n");
  config_saadc();
  printk("setting up ppi\n");
  config_ppi();
  printk("setup ppi\n");
  irq_enable(DT_IRQN(DT_NODELABEL(adc)));
  printk("setting up timer\n");
  k_msleep(1000);

  config_timer();

  // nrf_saadc_task_trigger(NRF_SAADC, NRF_SAADC_TASK_START);
  printk("ADC setup finished, taking samples at %d Hz\n",
         CONFIG_TX_BROADCAST_FREQUENCY);
  while (1) {
    // printk("Starting ADC loop\n");
    // k_msleep(1000);
    nrfx_timer_clear(&timer_inst);
    // printk("Clear timer\n");
    // k_msleep(1000);
    nrfx_saadc_buffer_set(sample_buf, CONFIG_TX_SAMPLE_NUMBER);
    // printk("Buffer set\n");
    // k_msleep(1000);

    nrfx_saadc_mode_trigger();
    // printk("Triggeeredd\n");
    // k_msleep(1000);
    nrfx_timer_enable(&timer_inst);
    // printk("enabled timer\n");
    // k_msleep(1000);
    // use semaphore to know when samples ready
    k_sem_take(&adc_semaphore, K_FOREVER);
    // printk("taken semaphore\n");
    // k_msleep(1000);
    nrfx_timer_disable(&timer_inst);
    // printk("disabled timer\n");
    // k_msleep(1000);
    tx_matched_filter(&cached_s_c);
    // printk("matched teh fileer\n");
    // k_msleep(1000);
    k_msleep(1000 / CONFIG_TX_BROADCAST_FREQUENCY);
  }
}
