SpindlySpider/spindlyVR/(commit log)

2025-11-27 Moved stepper motor code
2025-11-27 Updated code to drive stepper
2025-11-28 Added spool 3d models
    [adjustable_spool.FCStd, tri-axis-magnet.FCStd]
2025-11-29 Update design of triaxis magnet
    Updated design adding:
    - mounting holes
    - curve for easier routing of wire
    [tri-axis-magnet.FCStd]
2025-11-30 Updated to make parametric work
    [tri-axis-assembly.FCStd, tri-axis-magnet.FCStd, tri_axis_stepper_motor_mount.FCStd]
2025-11-30 Updated spool models
    [adjustable_spool.FCStd, stepper_motor_mount.FCStd]
2025-11-30 Updated Code for stepper motor driving
2025-11-30 Updated code to allow for speed up and speed down of stepper motor
    this prevents jittering issue
    [main.c]
2025-12-03 Moved tri-axis magnet
    [tri-axis-assembly.FCStd, tri-axis-magnet.FCStd, tri_axis_stepper_motor_mount.FCStd, ver-1-assembly.FCStd, ver-1-stepper-mount.FCStd, ver-1.FCStd]
2025-12-04 Add new version tri-axis reciver
    [ver-2.FCStd, ver-3-stepper-mount.FCStd .FCStd, ver-4-stepper-motor.FCStd, ver-4.FCStd]
2025-12-07 Added version 4 parts
    [ver-3.FCStd, ver-4-stepper-motor.FCStd]
2025-12-09 Added small driver for qmc5883p
2025-12-10 Working with filter
2025-12-11 Update to fix madgwick filter
    [imu.c, main.c, orientation_handle.c, pwm.c, qmc5883p.c]
2026-03-07 Started work on ADC for phase and amp
2026-03-07 Multi threading woking
2026-03-11 working ADC
2026-03-11 Clean up ADC code
2026-03-11 Update ADC to use NRFX timer properly
2026-03-12 Fixed ADC & ESB
    issue:
    - timer 2 was being used by ESB causing ADC to not work so switched to
    timer 3
    - Added .clangd for lsp
    - Tx was not working because of `selective_auto_ack` not being enabled
    [adc.c, transmit_data.c, transmit_data.h]
2026-03-12 ADC switching
    Added ADC switching to read from 3 different ADC sources
2026-03-15 Update spool size Tx was too weak
    - this is slightly bigger Tx to increase area, it may need to be
    increased further in the future
    [adjustable_spool.FCStd]
2026-03-15 Removed PWM from receiver board
2026-03-15 Fixed transmitter
    - PWM coil 2 was set to invert to maximuse H bridge useage
    [adc.c, adc.h, pwm.c]
2026-03-27 Added symbols for op amp and adc
    [rx.kicad_pcb, rx.kicad_sch]
2026-03-29 Fixed Tx phase and amp calc
    [adc.c, transmit_data.c, transmit_data.h]
2026-03-29 Added new symbols
    [rx_prototype.kicad_pcb, rx_prototype.kicad_sch]
2026-03-29 Save progress of prototype board
    [rx_prototype.kicad_sch]
2026-03-29 Back up prototype
    [rx_prototype.kicad_sch]
2026-03-29 Another prototype backup
    [rx_prototype.kicad_sch]
2026-03-30 Update wiring
    capcitors were in parallel would cause DC blocking
    [rx_prototype.kicad_pcb, rx_prototype.kicad_sch]
2026-03-30 Update prototype to include footprints for perfboard layout
    [rx_prototype.kicad_pcb, rx_prototype.kicad_sch]
2026-03-31 Update perfboard layout
    [rx_prototype.kicad_pcb, rx_prototype.kicad_sch]
2026-03-31 Update perf layout
    [rx_prototype.kicad_pcb, rx_prototype.kicad_sch]
2026-03-31 Update perf
    [rx_prototype.kicad_pcb, rx_prototype.kicad_sch]
2026-03-31 Completed perboard prototype
    [rx_prototype.kicad_pcb, rx_prototype.kicad_sch]
2026-03-31 Compacted Perfboard
    [rx_prototype.kicad_pcb]
2026-03-31 Backup Prototype
    [rx.kicad_sch, rx_prototype.kicad_pcb, rx_prototype.kicad_sch]
2026-04-02 Update perfboard prototype front end
    [rx.kicad_pcb, rx_prototype.kicad_pcb]
2026-04-03 Created rx board for order
    [rx.kicad_pcb, rx.kicad_sch, rx_prototype.kicad_pcb, rx_prototype.kicad_sch]
2026-04-03 Finished Rx
    [rx.kicad_pcb, rx.kicad_sch]
2026-04-04 Backup from work
    [adjustable_spool.FCStd, rx.csv, rx.kicad_pcb]
2026-04-05 Update Rx board to include anchor
    [rx-proto0.kicad_pcb, rx-proto0.kicad_sch, rx.kicad_pcb, rx.kicad_sch]
2026-04-20 Update to include phase sync
    lots of work went into this one,
    new syncing over ESB, (could be done over bluetooth)
    not relying on CPU to wake up instead update last messages phase
    [body_ver0.FCStd, ver-5.FCStd, ver-6-coil_001.step, ver-6-coil_003.step, ver-6-key001.step, ver-6.FCStd]
2026-04-21 Update to include positoning data
    currently not fully functional, the phase drift issue still occurs need
    to fix this, but it is progress
    [adc.c, data_handle.h, main.c, position.c, position.h]
2026-04-22 Update to use correct orientation
    [MadgwickAHRS.c, orientation_handle.c, qmc5883p.c]
2026-05-10 Reduce duty cycle for compliance
    driving at 3.3V and 0.5 duty cycle was above 150mA RMS
    Update to include pin sleep
2026-05-10 Update ADC to clean up code and improve functionality
    implemeted dynamic coil selection, sign extraction is much more stable
2026-05-10 Added calibration script
    Update formatting
    [coil_data_2.csv]
2026-05-10 Update coil calibration script & coil gain
2026-05-10 Fixed positioning 0 issue
    now need to fix the jitter mess
    [position.c]
2026-05-12 Add kalman noise finder
    [kalman_noise_finder.py]
2026-05-12 Removed dynamic coil switching
    issues where the sign was not anchored
    [adc.c]
2026-05-13 Added gyro bias calibration at startup
2026-05-13 Add calibration button
2026-05-14 Added grid calibration helper
2026-05-14 Added helper scripts for grid calibration
